VitaliiUspalenko/Turntable_v1.0/Images/device1.jpg

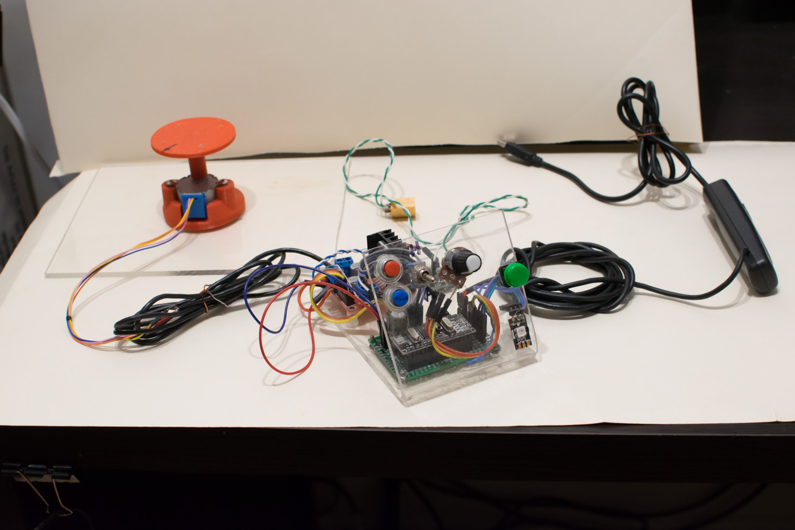
Images/device1.jpg
