VitaliiUspalenko/Turntable_v1.0/Images/device2.jpg

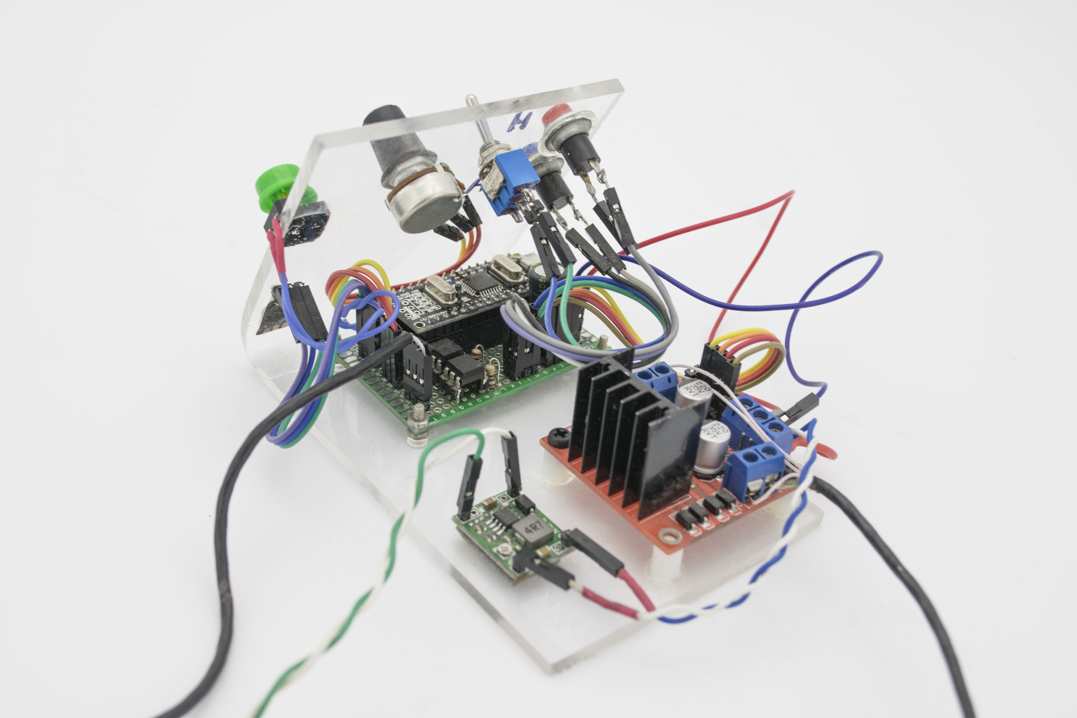
Images/device2.jpg
