VitaliiUspalenko/Turntable_v1.0/Images/h-mod.jpg

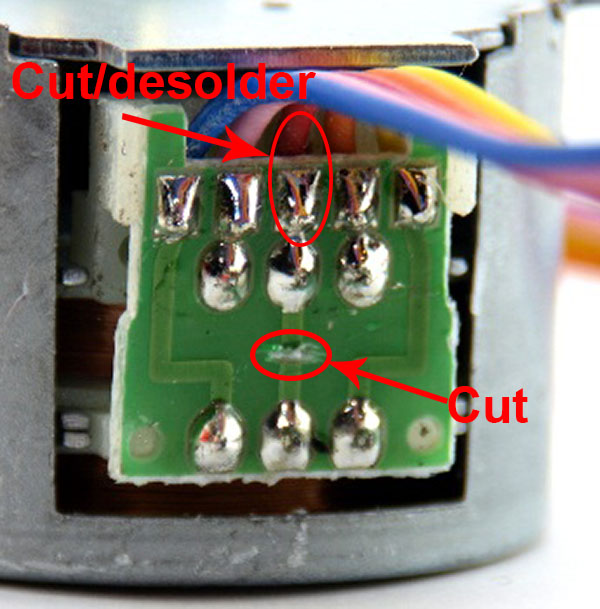
Images/h-mod.jpg
